KarlHanz/ACTermostat/photo/Screenshot_5.jpg

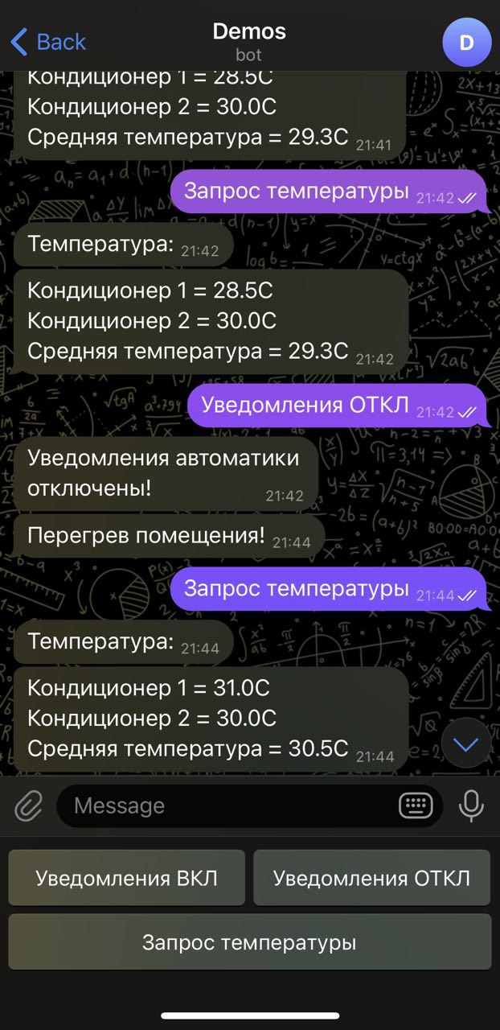
photo/Screenshot_5.jpg
