KarlHanz/ACTermostat/photo/device.jpg

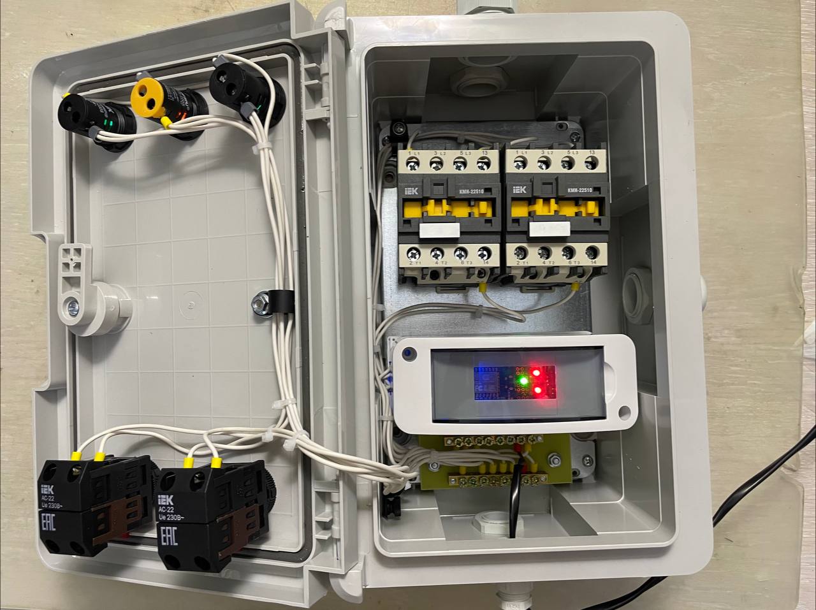
photo/device.jpg
