KarlHanz/ACTermostat/README.md

# ACThermostat

Автоматическое и ручное управление двумя кондиционерами в серверной по средней температуре от разнесённых датчиков через GUI. Уведомления системы отправляются в телеграмм-бот.
