KarlHanz/ACTermostat/photo/Screenshot_4.jpg

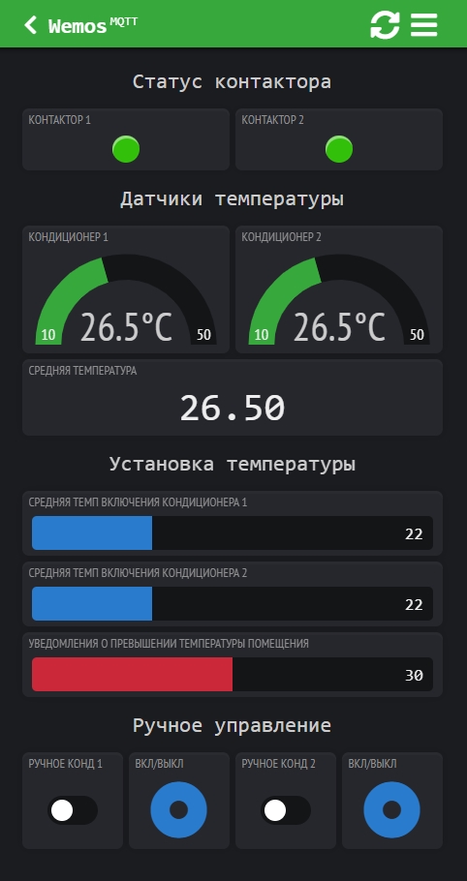
photo/Screenshot_4.jpg
