KarlHanz/ACTermostat/photo/Screenshot_7.jpg

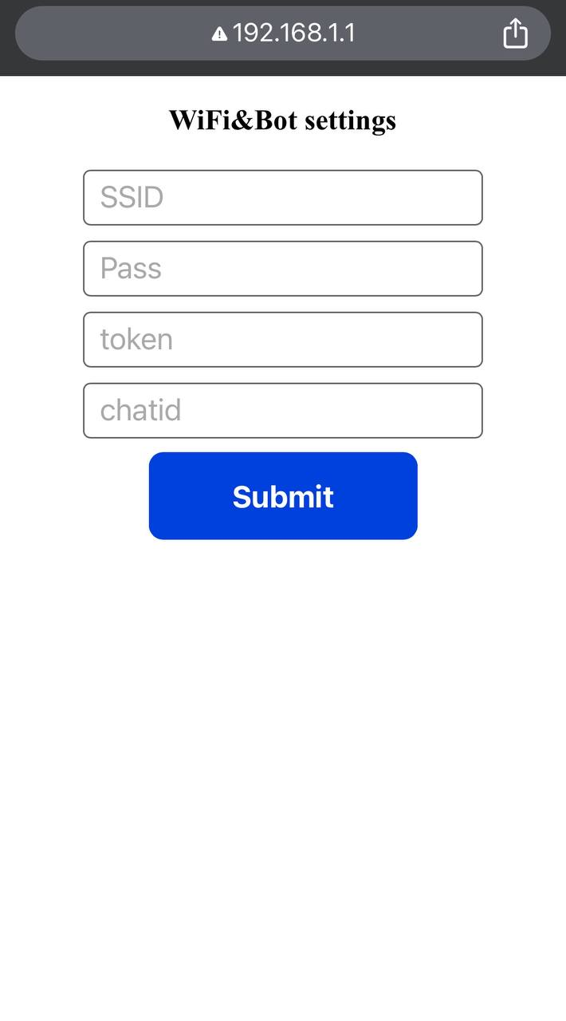
photo/Screenshot_7.jpg
