KarlHanz/ACTermostat/Schematic_termoRelayControl_2023-07-18.pdf

# A0 10 D0 11 D5 12 D6 13 D7 14 D8 15 3V3 16

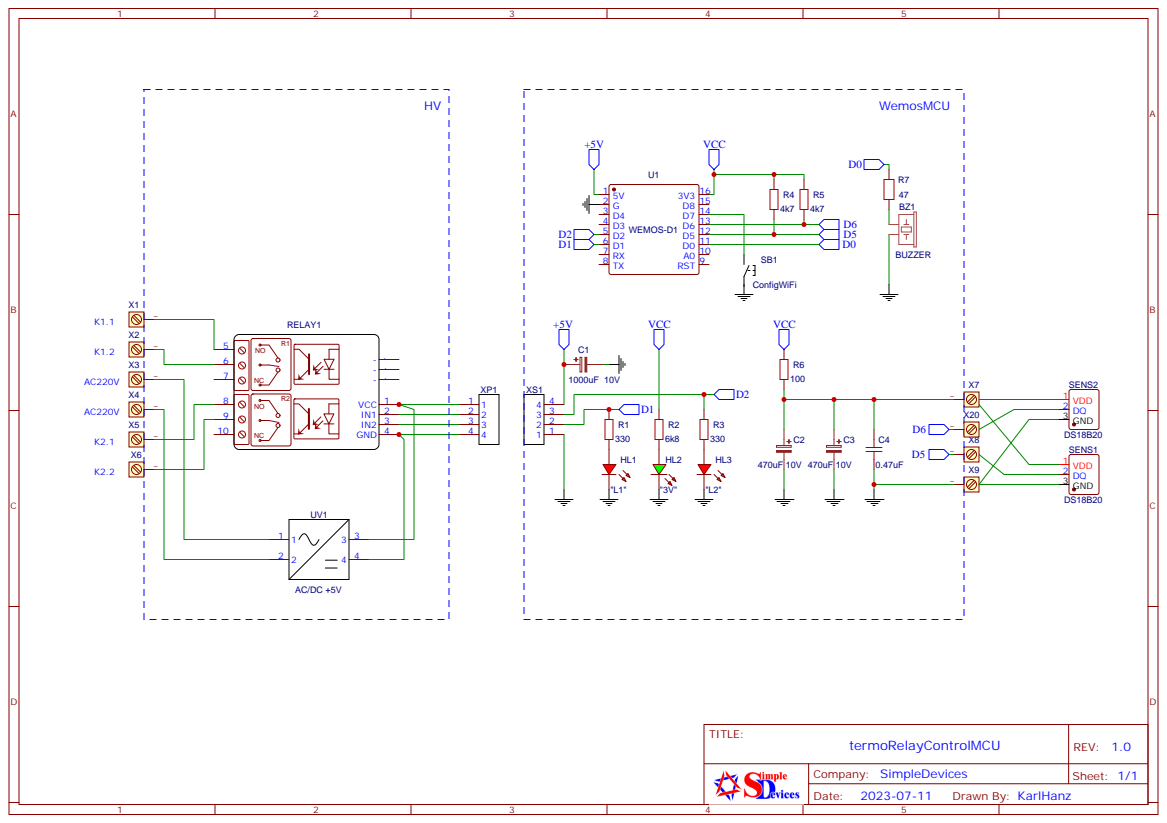
[picture p10: page 1]

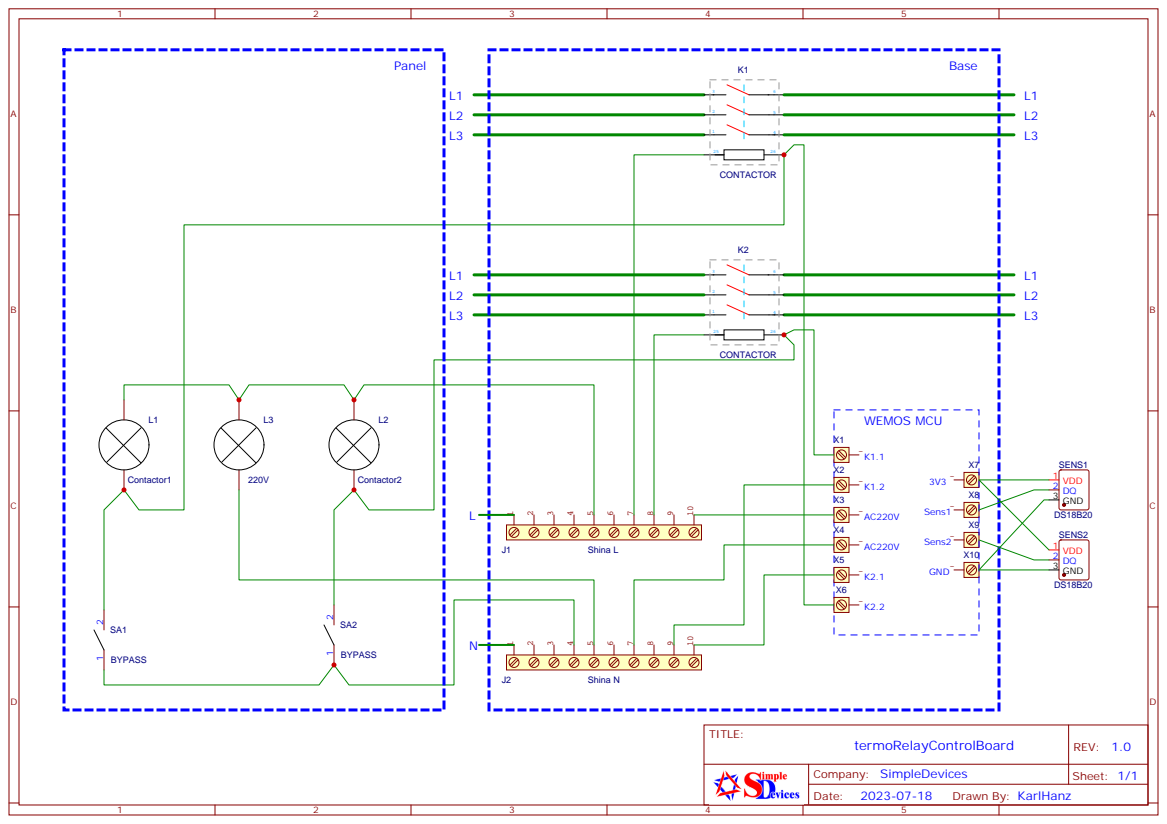
[picture p11: page 2]
